LaurentPointCa/lifebreach/hrv_uart.cpp

#include <Arduino.h>
#include "driver/uart.h"
#include "soc/uart_reg.h"
#include "hrv_uart.h"
#include "hrv_protocol.h"
#include "config.h"

// ── Shared state ───────────────────────────────────────────────────────────

hrv_state_t   hrv_state = {MODE_UNKNOWN, 0, false, false, 0, 0, 0};
uint32_t      bath_timer_start = 0;

volatile uint8_t  tx_command_byte = 0xFF;
volatile bool     tx_pending = false;
volatile uint32_t tx_frame_decoded_us = 0;
bool              tx_active = false;

uint8_t  lcd_rx_last_cmd = 0xFF;
bool     lcd_rx_valid = false;
bool     lcd_bath_timer = false;
uint32_t lcd_bath_timer_start = 0;
uint32_t lcd_bath_timer_count = 0;

// ── Private state ──────────────────────────────────────────────────────────

static QueueHandle_t uart_queue;
static QueueHandle_t lcd_uart_queue;

static uint8_t frame_buf[HRV_FRAME_LEN];
static uint8_t frame_buf_pos = 0;

static uint8_t last_lcd_byte = 0xFF;
static bool    lcd_byte_valid = false;
static bool    capture_next_lcd = false;

// LCD relay state — hardware timer ISR sends one byte every 20ms
static uint8_t  lcd_relay_buf[HRV_FRAME_LEN];
static volatile uint8_t lcd_relay_pos = HRV_FRAME_LEN;
static volatile bool lcd_relay_start_pending = false;
static hw_timer_t* lcd_relay_timer = NULL;
#define LCD_BYTE_INTERVAL_US  20094  // Match HRV's native ~20.094ms byte spacing

// LCD RX state — parse stream to discard HRV frame echoes, capture LCD commands
static uint8_t lcd_rx_frame_pos = 0;  // 0 = not in frame, 1-9 = discarding frame bytes

// ISR: writes directly to UART1 FIFO register — no driver calls, no locks.
// When lcd_relay_pos >= HRV_FRAME_LEN, ISR fires but does nothing (harmless).
void IRAM_ATTR lcd_relay_isr() {
    if (lcd_relay_pos < HRV_FRAME_LEN) {
        WRITE_PERI_REG(UART_FIFO_REG(1), lcd_relay_buf[lcd_relay_pos]);
        lcd_relay_pos++;
    }
}

// ── TX delay lookup ────────────────────────────────────────────────────────
// Timing is part of the protocol — each command has a unique delay.
// Microseconds from tx_frame_decoded_us capture to TX byte start.
// Pattern: ~500us (1 bit period) step per speed level.
//
// Two calibration sets: HRV_DEBUG=1 captures the timestamp AFTER ~440us of
// Serial.printf overhead. HRV_DEBUG=0 captures immediately after decode,
// so all delays are 440us longer to hit the same absolute time from D7.

uint16_t get_tx_delay_us(uint8_t cmd_byte) {
    switch (cmd_byte) {
#if HRV_DEBUG
        case 0xCF: case 0xDF: return  560;  // Fan 1: 5.86ms from D7 start
        case 0xE7: case 0xEF: return 1060;  // Fan 2: 6.36ms from D7 start
        case 0xF3: case 0xF7: return 1570;  // Fan 3: 6.87ms from D7 start
        case 0xF9: case 0xFB: return 2070;  // Fan 4: 7.37ms from D7 start
        case 0xFC: case 0xFD: return 2580;  // Fan 5: 7.88ms from D7 start
        case 0xFF: default:   return 3590;  // Idle:  8.89ms from D7 start
#else
        case 0xCF: case 0xDF: return 1000;  // Fan 1: 5.86ms from D7 start
        case 0xE7: case 0xEF: return 1500;  // Fan 2: 6.36ms from D7 start
        case 0xF3: case 0xF7: return 2010;  // Fan 3: 6.87ms from D7 start
        case 0xF9: case 0xFB: return 2510;  // Fan 4: 7.37ms from D7 start
        case 0xFC: case 0xFD: return 3020;  // Fan 5: 7.88ms from D7 start
        case 0xFF: default:   return 4030;  // Idle:  8.89ms from D7 start
#endif
    }
}

// ── UART initialization ────────────────────────────────────────────────────

void hrv_uart_init() {
    uart_config_t uart_config = {
        .baud_rate  = HRV_BAUD,
        .data_bits  = UART_DATA_8_BITS,
        .parity     = UART_PARITY_DISABLE,
        .stop_bits  = UART_STOP_BITS_1,
        .flow_ctrl  = UART_HW_FLOWCTRL_DISABLE,
        .source_clk = UART_SCLK_APB,
    };
    uart_param_config(HRV_UART_NUM, &uart_config);
    uart_set_pin(HRV_UART_NUM, HRV_TX_PIN, HRV_RX_PIN, UART_PIN_NO_CHANGE, UART_PIN_NO_CHANGE);
    uart_driver_install(HRV_UART_NUM, HRV_BUF_SIZE, 0, 32, &uart_queue, 0);
    uart_set_line_inverse(HRV_UART_NUM, UART_SIGNAL_RXD_INV);
    uart_set_rx_full_threshold(HRV_UART_NUM, 1);
    uart_set_rx_timeout(HRV_UART_NUM, 2);
}

void lcd_uart_init() {
    uart_config_t uart_config = {
        .baud_rate  = HRV_BAUD,
        .data_bits  = UART_DATA_8_BITS,
        .parity     = UART_PARITY_DISABLE,
        .stop_bits  = UART_STOP_BITS_1,
        .flow_ctrl  = UART_HW_FLOWCTRL_DISABLE,
        .source_clk = UART_SCLK_APB,
    };
    uart_param_config(LCD_UART_NUM, &uart_config);
    uart_set_pin(LCD_UART_NUM, LCD_TX_PIN, LCD_RX_PIN, UART_PIN_NO_CHANGE, UART_PIN_NO_CHANGE);
    uart_driver_install(LCD_UART_NUM, LCD_BUF_SIZE, LCD_BUF_SIZE, 32, &lcd_uart_queue, 0);
    // No RXD inversion — LCD RX uses a voltage divider (no opto to invert)
    // uart_set_line_inverse(LCD_UART_NUM, UART_SIGNAL_RXD_INV);

    // Hardware timer ISR for precise byte relay to LCD panel.
    // Runs continuously — ISR checks lcd_relay_pos and does nothing
    // when there's no frame to relay (pos >= HRV_FRAME_LEN).
    // 1MHz = 1us/tick, alarm at 20094 ticks = 20.094ms (matches HRV clock).
    lcd_relay_timer = timerBegin(1000000);
    timerAttachInterrupt(lcd_relay_timer, &lcd_relay_isr);
    timerAlarm(lcd_relay_timer, LCD_BYTE_INTERVAL_US, true, 0);
}

// ── Frame decoding ─────────────────────────────────────────────────────────

// Structural validity: correct sync byte and 5-byte tail. This is what qualifies
// a frame for passthrough (LCD relay + bus TX response), independent of whether we
// recognize the speed/mode code.
static bool hrv_frame_valid(const uint8_t* buf) {
    if (buf[0] != HRV_SYNC_BYTE) return false;
    for (int i = 0; i < 5; i++) {
        if (buf[5 + i] != HRV_TAIL[i]) return false;
    }
    return true;
}

// Speed/mode lookup: maps (B1,B2,B3) to mode + fan speed. Returns false for codes
// not in FRAME_LOOKUP (e.g. the HRV's 0x9E status code) — caller must NOT drop such
// frames, only skip updating mode/fan.
static bool hrv_lookup_speed(uint8_t b1, uint8_t b2, uint8_t b3,
                             hrv_mode_t* mode, uint8_t* fan) {
    for (int i = 0; i < FRAME_LOOKUP_COUNT; i++) {
        if (FRAME_LOOKUP[i].b1 == b1 &&
            FRAME_LOOKUP[i].b2 == b2 &&
            FRAME_LOOKUP[i].b3 == b3) {
            *mode = FRAME_LOOKUP[i].mode;
            *fan  = FRAME_LOOKUP[i].fan_speed;
            return true;
        }
    }
    return false;
}

bool hrv_decode_lcd(uint8_t val, hrv_mode_t* mode, uint8_t* fan) {
    for (int i = 0; i < LCD_COMMANDS_COUNT; i++) {
        if (LCD_COMMANDS[i].byte_val == val) {
            *mode = LCD_COMMANDS[i].mode;
            *fan  = LCD_COMMANDS[i].fan_speed;
            return true;
        }
    }
    return false;
}

// ── Frame sync and byte processing ────────────────────────────────────────

static void hrv_process_byte(uint8_t val) {
    if (capture_next_lcd) {
        last_lcd_byte = val;
        lcd_byte_valid = true;
        capture_next_lcd = false;
    }

    if (frame_buf_pos < HRV_FRAME_LEN) {
        frame_buf[frame_buf_pos++] = val;
    } else {
        memmove(frame_buf, frame_buf + 1, HRV_FRAME_LEN - 1);
        frame_buf[HRV_FRAME_LEN - 1] = val;
    }

    if (frame_buf_pos < HRV_FRAME_LEN) return;

    // Passthrough (LCD relay + bus TX response) runs for ANY structurally-valid
    // frame — NOT gated on recognizing the speed/mode code. An unrecognized but
    // valid frame (e.g. the HRV's 0x9E status code) must keep the bridge alive;
    // gating relay/TX on the lookup is what caused the 2026-06-15 silent hang.
    if (hrv_frame_valid(frame_buf)) {
        hrv_state.last_frame_ms = millis();
        hrv_state.frame_count++;

        hrv_mode_t mode = MODE_UNKNOWN;
        uint8_t    fan  = 0;
        bool flagged    = false;
        bool recognized = hrv_lookup_speed(frame_buf[1], frame_buf[2], frame_buf[3],
                                           &mode, &fan);
        if (!recognized && (frame_buf[2] & 0x01) == 0) {
            // The HRV sets a status flag by clearing bit0 of B2 (e.g. 0x9E from
            // 0x9F at Fresh 0, 0x98 from 0x99 at Fresh 5 — both verified on the
            // bus). Normalize to recover the real mode/fan; report the flag too.
            recognized = hrv_lookup_speed(frame_buf[1], frame_buf[2] | 0x01,
                                          frame_buf[3], &mode, &fan);
            flagged = recognized;
        }
        if (recognized) {
            hrv_state.mode          = mode;
            hrv_state.fan_speed     = fan;
            hrv_state.valid         = true;
            hrv_state.special_flag  = flagged;
            if (flagged) {
                hrv_state.special_b1 = frame_buf[1];
                hrv_state.special_b2 = frame_buf[2];
                hrv_state.special_b3 = frame_buf[3];
                hrv_state.special_b4 = frame_buf[4];
                hrv_state.special_count++;
            } else {
                hrv_state.special_count = 0;
            }
        } else {
            // Valid frame, unrecognized even after normalizing — keep last mode/fan.
            hrv_state.special_flag  = true;
            hrv_state.special_count++;
            hrv_state.special_b1 = frame_buf[1];
            hrv_state.special_b2 = frame_buf[2];
            hrv_state.special_b3 = frame_buf[3];
            hrv_state.special_b4 = frame_buf[4];
        }

#if HRV_DEBUG
        // Debug output MUST stay before tx_frame_decoded_us capture.
        // The debug TX delay values (560-3590us) are calibrated with ~0.44ms
        // of Serial.printf overhead between frame decode and timestamp capture.
        Serial.printf("#%lu  ", hrv_state.frame_count);
        for (int i = 0; i < HRV_FRAME_LEN; i++) {
            Serial.printf("%02X ", frame_buf[i]);
        }
        if (recognized) {
            Serial.printf(" %s Fan %d%s", hrv_mode_str(mode), fan,
                          flagged ? " [FLAG]" : "");
        } else {
            Serial.print(" UNKNOWN code (relayed)");
        }

        if (lcd_byte_valid) {
            hrv_mode_t lcd_mode;
            uint8_t    lcd_fan;
            Serial.printf("  LCD:%02X", last_lcd_byte);
            if (hrv_decode_lcd(last_lcd_byte, &lcd_mode, &lcd_fan)) {
                if (lcd_mode != MODE_UNKNOWN) {
                    Serial.printf(" (%s Fan %d)", hrv_mode_str(lcd_mode), lcd_fan);
                } else {
                    Serial.print(" (idle)");
                }
            }
        }
        Serial.println();
#endif

        lcd_byte_valid = false;
        capture_next_lcd = true;

        // TX timestamp — production values account for no debug print overhead
        tx_pending = true;
        tx_frame_decoded_us = micros();

        // Queue HRV frame for LCD relay — actual start deferred to hrv_task
        // AFTER hrv_tx_send completes, to avoid timing interference
        memcpy(lcd_relay_buf, frame_buf, HRV_FRAME_LEN);
        lcd_relay_start_pending = true;

        frame_buf_pos = 0;
    } else {
        hrv_state.error_count++;
    }
}

// ── TX send ────────────────────────────────────────────────────────────────

static void hrv_tx_send() {
    uint8_t cmd = tx_command_byte;  // snapshot volatile
    uint16_t delay_us = get_tx_delay_us(cmd);

    // Spin-wait for exact timing — this task runs at high priority,
    // nothing except ISRs can preempt it
    while ((micros() - tx_frame_decoded_us) < delay_us) { /* spin */ }

    uart_write_bytes(HRV_UART_NUM, (const char*)&cmd, 1);
    tx_pending = false;
}

// ── HRV dedicated task (FreeRTOS, high priority, core 1) ───────────────────
// Handles UART RX, frame decode, and precision TX timing.
// Immune to OLED I2C, WiFi, MQTT blocking on the main loop.

void hrv_task(void* param) {
    for (;;) {
        // Check for UART break events (bathroom timer)
        uart_event_t event;
        while (xQueueReceive(uart_queue, &event, 0) == pdTRUE) {
            if (event.type == UART_BREAK) {
                hrv_state.bath_timer = true;
                bath_timer_start = millis();
            }
        }

        // Block until a byte arrives (yields CPU efficiently via semaphore).
        // Returns immediately when data is available — near-zero latency.
        uint8_t byte;
        if (uart_read_bytes(HRV_UART_NUM, &byte, 1, pdMS_TO_TICKS(1)) == 1) {
            hrv_process_byte(byte);

            // Drain any remaining buffered bytes without waiting
            uint8_t rx_buf[31];
            int len = uart_read_bytes(HRV_UART_NUM, rx_buf, sizeof(rx_buf), 0);
            for (int i = 0; i < len; i++) {
                hrv_process_byte(rx_buf[i]);
            }
        }

        // TX: spin-wait for precise timing then send
        if (tx_pending) {
            hrv_tx_send();
        }

        // LCD relay: let hardware timer ISR send all 10 bytes (B0-B9)
        // with perfect 20ms spacing. B0 waits for next timer tick.
        if (lcd_relay_start_pending) {
            lcd_relay_start_pending = false;
            lcd_relay_pos = 0;
            lcd_rx_frame_pos = 0;  // reset frame parse state for new relay
        }
    }
}

// ── LCD RX polling (call from main loop) ──────────────────────────────────
// Parses the LCD UART RX stream to separate HRV frame echoes from LCD commands.
// Since TX and RX share the same wire, every byte we relay echoes back.
// The HRV frame always starts with 0xBF (no LCD command uses that value),
// so we use it as a sync marker: 0xBF + 9 bytes = frame echo (discard),
// anything else = LCD panel command byte.

void lcd_rx_poll() {
    // Drain UART events — a 7ms LOW pulse from an attached bathroom timer
    // arrives as UART_BREAK (longer than one 2000-baud frame).
    uart_event_t event;
    while (xQueueReceive(lcd_uart_queue, &event, 0) == pdTRUE) {
        if (event.type == UART_BREAK) {
            lcd_bath_timer = true;
            lcd_bath_timer_start = millis();
            lcd_bath_timer_count++;
#if HRV_DEBUG
            Serial.printf("LCD RX: BREAK (bathroom timer) #%lu\n", lcd_bath_timer_count);
#endif
        }
    }

    uint8_t buf[32];
    int len = uart_read_bytes(LCD_UART_NUM, buf, sizeof(buf), 0);
    for (int i = 0; i < len; i++) {
        if (lcd_rx_frame_pos > 0) {
            // Inside a frame echo — discard remaining bytes
            lcd_rx_frame_pos++;
            if (lcd_rx_frame_pos >= HRV_FRAME_LEN) {
                lcd_rx_frame_pos = 0;
            }
        } else if (buf[i] == HRV_SYNC_BYTE) {
            // Start of HRV frame echo — discard this and next 9 bytes
            lcd_rx_frame_pos = 1;
        } else {
            // LCD panel command byte
            lcd_rx_last_cmd = buf[i];
            lcd_rx_valid = true;
#if HRV_DEBUG
            Serial.printf("LCD RX: 0x%02X", buf[i]);
            hrv_mode_t lcd_mode;
            uint8_t    lcd_fan;
            if (hrv_decode_lcd(buf[i], &lcd_mode, &lcd_fan)) {
                if (lcd_mode != MODE_UNKNOWN) {
                    Serial.printf(" (%s Fan %d)", hrv_mode_str(lcd_mode), lcd_fan);
                } else {
                    Serial.print(" (idle)");
                }
            }
            Serial.println();
#endif
        }
    }
}
