LaurentPointCa/lifebreach/(commit log)

2026-04-03 Initial commit: LifeBreach ESP32 HRV monitor
    ESP32-based passive monitor for LifeBreath RNC6-ES HRV unit.
    Decodes 2000-baud UART protocol (mode, fan speed, bathroom timer)
    and displays status on SSD1306 128x64 OLED.
2026-04-03 Fix UART reception and polish OLED status display
    - Set UART FIFO threshold to 1 byte (was 120) to fix bursty reception
    at 2000 baud causing intermittent "WAITING..." on OLED
    - Increase UART event queue from 8 to 32 slots
    - Uptime counter scales: seconds -> minutes -> hours (1dp) -> days (1dp)
    - Frame counter switches to thousands (1dp) after 9999
    - Adjust display layout Y positions
    [lifebreach.ino]
2026-04-03 Add WiFi, MQTT, Home Assistant integration and Phase 2 TX
    - WiFiManager captive portal for WiFi + MQTT broker configuration
    - PubSubClient MQTT: publish HRV state, subscribe to commands
    - Home Assistant auto-discovery (mode, fan, uptime, RSSI sensors)
    - ArduinoOTA for over-the-air firmware updates
    - Phase 2 TX: send LCD command bytes with precise microsecond timing
    - BOOT button: short press toggles TX, long press (3s) resets WiFi
    - TX timing calibrated to 860us from frame decode (~5.86ms from D7)
    - OLED shows IP address and MQTT connection status
    - config.h: MQTT topics, OTA settings, HA discovery constants
    - TX_TIMING_FINDINGS.md: protocol timing analysis documentation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
    [config.h, hrv_protocol.h, lifebreach.ino]
2026-04-03 FreeRTOS task for jitter-free TX + calibrated per-command timing
    - Move HRV UART + TX to dedicated FreeRTOS task (priority 19, core 1)
    using uart_read_bytes blocking for near-zero latency byte processing
    - Per-command TX delay table matching real LCD timing slots:
    Fan 1-5 at 5.86/6.36/6.87/7.37/7.88ms, Idle at 8.89ms from D7 start
    - Spin-wait in high-priority task gives sub-0.1ms jitter, immune to
    OLED I2C, WiFi, and MQTT blocking
    - Zero collisions, zero bad cycles across full 10-command test sequence
    - Add BOOT button test sequence cycling all mode/fan combinations
    - OLED title shows active command ("CMD: Fresh Fan 3") during TX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
    [lifebreach.ino]
2026-04-04 Update TX timing findings: mark fully resolved with final calibrated values
2026-04-04 Refactor into modules and add LCD panel relay (Phase 3 Step 1)
    Split monolithic lifebreach.ino into hrv_uart, wifi_mqtt, and display
    modules. Add UART1 (GPIO4/5) for LCD panel relay — forwards HRV frames
    to LCD with 20ms byte spacing to match native protocol timing. Remove
    temporary TX_TIMING_FINDINGS.md.
2026-04-04 Hardware timer ISR for LCD relay and match HRV clock drift
    Replace esp_timer (task-based) with hardware timer ISR for LCD byte
    relay. ISR writes directly to UART1 FIFO register with microsecond
    precision. Match HRV's native 20.094ms byte spacing (4721 ppm slow)
    to prevent cumulative drift that caused LCD to reject frames.
    Add project README.
    [hrv_uart.cpp]
2026-04-04 LCD RX parsing, OLED dual-status display, and HRV_DEBUG compile flag
    Wire LCD panel to ESP32 via voltage divider (optocouplers abandoned).
    Add LCD UART RX that parses shared wire using 0xBF sync to discard
    HRV frame echoes and capture LCD command bytes. Update OLED to show
    both LCD command and HRV status in compact "MODE | N" format.
    Gate all Serial output behind HRV_DEBUG in config.h with dual TX delay
    calibration: debug values (560-3590us) and production values (1000-4030us,
    +440us offset). Production calibration verified via hrv3-esp-test10.vcd
    (609 commands, <1us mean error).
    [config.h, hrv_uart.cpp, hrv_uart.h, lifebreach.ino, wifi_mqtt.cpp]
2026-04-19 LCD-side bathroom timer: detect, display, publish to HA
    Install LCD UART with an event queue and treat UART_BREAK as a
    bathroom-timer pulse (7ms LOW on the wire exceeds one 2000-baud
    frame). Render "TIMER!" on OLED Line 1 (LCD status row) with the
    existing 3s auto-clear window; HRV-side timer continues to override
    Line 2. Publish `lcd_bath_timer` plus a monotonic `lcd_bath_timer_count`
    in the MQTT state payload and expose them via HA auto-discovery as a
    binary_sensor (live state) and a total_increasing counter (reconnect-
    safe edge log for automations).
    Also fix README diode reference (1N4007 -> 1N4148) and add missing
    config.h include in hrv_uart.cpp.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
    [hrv_uart.cpp, hrv_uart.h, lifebreach.ino, wifi_mqtt.cpp]
2026-06-16 Fix bus hang on unrecognized HRV frames (e.g. 0x9E status code)
    The bridge went permanently silent whenever the HRV broadcast a
    structurally-valid frame whose (B1,B2,B3) wasn't in FRAME_LOOKUP — e.g.
    the 0x9E speed/status code first seen 2026-06-15 14:37. Both the LCD
    relay and the bus TX response were gated on hrv_decode_frame()
    succeeding, so an unrecognized code stopped all relay/response. Because
    0x9E persists, the bridge stayed silent until an HRV power-cycle (an
    ESP32 reboot just re-read 0x9E and re-silenced) — matching the reported
    symptom that only power-cycling the HRV recovers it.
    Decouple passthrough from the speed lookup:
    - Split hrv_decode_frame() into hrv_frame_valid() (sy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
    [hrv_protocol.h, hrv_uart.cpp, lifebreach.ino]
2026-06-16 Decode speed under the B2 status flag + expose flag to HA
    The HRV's 0x9E is a status flag that clears bit0 of the B2 speed byte
    (0x9F->0x9E at Fresh 0, 0x99->0x98 at Fresh 5, both verified on the bus).
    While latched, every B2 is an even value absent from FRAME_LOOKUP, so the
    exact-match lookup failed on every frame: mode/fan never updated and the
    HA sensors sat at their defaults even though control worked.
    - hrv_uart.cpp: on a lookup miss with (B2 & 1)==0, retry with B2|0x01 to
    recover the real mode/fan, and report it via hrv_state.special_flag.
    Normal frames are unaffected (exact match still wins).
    - lifebreach.ino: OLED status line shows the real decoded speed again;
    the "! FLAG <b1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
    [hrv_uart.cpp, lifebreach.ino, wifi_mqtt.cpp]
